Stew-000-1-0-011/voyager/docs/harness.md

# 基板外の配線

このファイルは `mechanical/harness.py` が生成する。手で編集しない。図は `mechanical/images/harness.png`。

- ケーブルはアルミフレームの上面か外面に沿わせ、結束バンドで 50〜80mm おきに留める。電装トレイの上では基板とモジュールの間をゆるく回す。
- 長さは図の経路に両端の余裕 60mm を足して 50mm 単位に切り上げた目安。実物に当てて切る。
- 電源の流れ:電池 → XT60 → ヒューズ 10A → メインスイッチ → 非常停止 → 電源分岐(レバー式コネクタ) → DRV8871 ×3 の電源端子と基板の J_PWR。電池の − は電源分岐の − へ直接つなぐ。
- モーターの 6P ケーブルは中間クロス材の前で、M1/M2(ドライバへ)とエンコーダ4本(基板へ)に分ける。
- モジュールの置き場所(トレイ上、基板の前): DRV_L / DRV_G / DRV_R を左から順に、降圧モジュールを右端。メインスイッチと電源分岐はトレイの左奥。

| 記号 | 区間 | 線材 | 端末 | 長さの目安 | 備考 |
|---|---|---|---|---|---|
| P1 | 電池 → メインスイッチ(+)/ 電源分岐(−) | AWG16 赤黒 | XT60 オス ↔ 圧着端子 | 250mm | 平形ヒューズ 10A を + 側の途中に入れる。− は分岐まで同じ経路で並走させる |
| P2 | メインスイッチ → 非常停止 | AWG16 | 圧着端子 | 150mm |  |
| P3 | 非常停止 → 電源分岐(+) | AWG16 | 圧着端子 ↔ レバー式コネクタ | 150mm |  |
| P4 | 電源分岐 → DRV_L の電源端子(VM, GND) | AWG18 赤黒 | レバー式コネクタ ↔ ネジ端子 | 200mm | 基板の左脇から前へ回し、ドライバの前を通す |
| P5 | 電源分岐 → DRV_G の電源端子(VM, GND) | AWG18 赤黒 | レバー式コネクタ ↔ ネジ端子 | 200mm | 基板の左脇から前へ回し、ドライバの前を通す |
| P6 | 電源分岐 → DRV_R の電源端子(VM, GND) | AWG18 赤黒 | レバー式コネクタ ↔ ネジ端子 | 250mm | 基板の左脇から前へ回し、ドライバの前を通す |
| P7 | 電源分岐 → 基板 J_PWR | AWG20 赤黒 | レバー式コネクタ ↔ ネジ端子 | 150mm |  |
| P8 | 基板 J_BUCK ↔ 降圧モジュール | AWG22 3本 | XH 3P ↔ はんだ付け | 300mm | 基板の左脇から前へ回す。基板を詰め直すときに J_BUCK を右前へ寄せれば短くなる |
| D1 | 基板 J_DRV_L → DRV_L の信号ピン | AWG26 4芯 | XH 4P ↔ ピンヘッダ用ソケット 4P(両端同じ順:GND, VM, IN1, IN2) | 150mm | VM の線は基板側で何もつながないので、抜いておいてもよい |
| D2 | 基板 J_DRV_G → DRV_G の信号ピン | AWG26 4芯 | XH 4P ↔ ピンヘッダ用ソケット 4P(両端同じ順:GND, VM, IN1, IN2) | 150mm | VM の線は基板側で何もつながないので、抜いておいてもよい |
| D3 | 基板 J_DRV_R → DRV_R の信号ピン | AWG26 4芯 | XH 4P ↔ ピンヘッダ用ソケット 4P(両端同じ順:GND, VM, IN1, IN2) | 100mm | VM の線は基板側で何もつながないので、抜いておいてもよい |
| M1 | 左駆動モーター → DRV_L 出力 | モーター付属 6P の M1, M2 | PH 6P ↔ ネジ端子 | 150mm | 6P ケーブルを中間クロス材の前で M1/M2 とエンコーダ4本に分ける |
| E1 | 左エンコーダ → 基板 J_ENC_L | モーター付属 6P の GND, VCC, A, B | PH 6P ↔ XH 4P | 200mm |  |
| M2 | 右駆動モーター → DRV_R 出力 | モーター付属 6P の M1, M2 | PH 6P ↔ ネジ端子 | 150mm | 6P ケーブルを中間クロス材の前で M1/M2 とエンコーダ4本に分ける |
| E2 | 右エンコーダ → 基板 J_ENC_R | モーター付属 6P の GND, VCC, A, B | PH 6P ↔ XH 4P | 200mm |  |
| M3 | 把持モーター → DRV_G 出力 | モーター付属 6P の M1, M2(延長) | PH 6P ↔ ネジ端子 | 250mm | モーター下端から中心線に沿って後ろへ。把持の上下動はないので固定でよい |
| E3 | 把持エンコーダ → 基板 J_ENC_G | モーター付属 6P の GND, VCC, A, B(延長) | PH 6P ↔ XH 4P | 300mm |  |
| S1 | 超音波 LF → 基板 J_US_LF | AWG26 4芯 | XH 4P ↔ ピンヘッダ用ソケット 4P(両端同じ順:Vcc, Trig, Echo, Gnd) | 400mm |  |
| S2 | 超音波 RF → 基板 J_US_RF | AWG26 4芯 | XH 4P ↔ ピンヘッダ用ソケット 4P(両端同じ順:Vcc, Trig, Echo, Gnd) | 350mm |  |
| S3 | 超音波 LR → 基板 J_US_LR | AWG26 4芯 | XH 4P ↔ ピンヘッダ用ソケット 4P(両端同じ順:Vcc, Trig, Echo, Gnd) | 300mm | 非常停止の前を回る |
| S4 | 超音波 RR → 基板 J_US_RR | AWG26 4芯 | XH 4P ↔ ピンヘッダ用ソケット 4P(両端同じ順:Vcc, Trig, Echo, Gnd) | 200mm | 電池箱の後ろ、後ろフレームの外面を通る |
| U1 | Bluepill USB → PC | USB ケーブル 3〜5m | Micro-B ↔ A | 3〜5m | 後ろへ出し、後ろフレームに結束して引っ張りを逃がす。USB アイソレータは PC 側に置く |
