Stew-000-1-0-011/voyager/electrical/perfboard.md

# ユニバーサル基板 配置・結線

このファイルは `gen_perfboard.py` が `netlist.py` から生成する。手で編集しない。

## Bluepill の向きの確認

- ソケット J_BP_A のピン1((19,4))に挿さる端子が **3V3**、J_BP_B のピン1((13,4))が **VB** であること。USB コネクタは基板の後端(行の大きい側)を向く。
- 実物のシルク印刷で確認する。違う場合は、ハンダ付けの前に `netlist.py` の `BLUEPILL_ROW_A` / `BLUEPILL_ROW_B` と `PLACEMENT` を直して再生成する。

## コネクタのピン順(ケーブル製作用)

ピン順は相手のモジュールの端子と同じなので、ケーブルはまっすぐ(1番どうし)つなぐ。GND のピンは基板の外周(GND の母線)側にある。図の□はピン1。空欄は基板側で何もつながないピン(ドライバの VM はバッテリーから直接)。

| コネクタ | 1 | 2 | 3 | 4 |
|---|---|---|---|---|
| J_BUCK(Buck module) | GND | VBAT | +5V |  |
| J_DRV_G(Driver IN) | GND | 未接続 | G_IN1 | G_IN2 |
| J_DRV_L(Driver IN) | GND | 未接続 | L_IN1 | L_IN2 |
| J_DRV_R(Driver IN) | GND | 未接続 | R_IN1 | R_IN2 |
| J_ENC_G(Encoder) | GND | +3V3 | ENC_G_A | ENC_G_B |
| J_ENC_L(Encoder) | GND | +3V3 | ENC_L_A | ENC_L_B |
| J_ENC_R(Encoder) | GND | +3V3 | ENC_R_A | ENC_R_B |
| J_PWR(VBAT in) | GND | VBAT |  |  |
| J_UART(UART) | GND | +3V3 | UART_TX | UART_RX |
| J_US_LF(HC-SR04) | +5V | US_TRIG_LF | US_ECHO_LF_RAW | GND |
| J_US_LR(HC-SR04) | +5V | US_TRIG_LR | US_ECHO_LR_RAW | GND |
| J_US_RF(HC-SR04) | +5V | US_TRIG_RF | US_ECHO_RF_RAW | GND |
| J_US_RR(HC-SR04) | +5V | US_TRIG_RR | US_ECHO_RR_RAW | GND |

## 部品配置

基板は 33 × 28 穴(2.54mm 格子、約 84 × 71mm)。部品面から見て、列 0 がロボットの左端、行 0 が前端。回転はピン番号が進む向き(0: 列+、90: 行+、180: 列−、270: 行−)。

| ref | 値 | ピン1の穴 | 回転 |
|---|---|---|---|
| C_BULK | 470u 25V | (4,25) | 90 |
| C_DIV | 100n | (10,22) | 0 |
| D_5V | 1N5819 | (13,26) | 0 |
| J_BP_A | Bluepill row A | (19,4) | 90 |
| J_BP_B | Bluepill row B | (13,4) | 90 |
| J_BUCK | Buck module | (7,27) | 270 |
| J_DRV_G | Driver IN | (21,0) | 90 |
| J_DRV_L | Driver IN | (11,0) | 90 |
| J_DRV_R | Driver IN | (24,0) | 90 |
| J_ENC_G | Encoder | (32,4) | 180 |
| J_ENC_L | Encoder | (0,7) | 0 |
| J_ENC_R | Encoder | (32,9) | 180 |
| J_PWR | VBAT in | (1,27) | 270 |
| J_UART | UART | (5,0) | 90 |
| J_US_LF | HC-SR04 | (3,16) | 180 |
| J_US_LR | HC-SR04 | (3,20) | 180 |
| J_US_RF | HC-SR04 | (29,20) | 0 |
| J_US_RR | HC-SR04 | (29,25) | 0 |
| R_DIV_H | 47k | (10,25) | 0 |
| R_DIV_L | 10k | (15,25) | 270 |
| R_ECHO_LF | 1k | (2,18) | 0 |
| R_ECHO_LR | 1k | (4,23) | 0 |
| R_ECHO_RF | 1k | (29,17) | 270 |
| R_ECHO_RR | 1k | (27,25) | 270 |
| R_USB | 1k8 DNP | (17,19) | 270 |

## 配線経路

配線はすべてはんだ面で行う。電源(VBAT、GND)も基板上の電流は小さい(降圧モジュールの入力と電圧測定だけ)ので、信号と同じ線で引く。作業順:(1)はんだ面の裸配線(すずめっき線を穴に沿って這わせ、通る穴ごとにはんだ付け)、(2)はんだ面の被覆線(耐熱の被覆線、たとえば AWG26〜30 の ETFE ラッピング線を、裸配線の上から穴の列に沿って這わせる。はんだ付けは両端だけで、端はピンのはんだの上か、裸配線の上に付ける。裸配線や他の被覆線とは直角に交差してよいが、途中で他のピンのはんだの上は通さない)。ポリウレタン線ははんだごての熱で被覆が溶けるので、交差に使わない。図は `images/perfboard_top.png`(部品面)、`images/perfboard_bottom.png`(はんだ面の裸配線)、`images/perfboard_wires.png`(はんだ面の被覆線)。はんだ面の図は左右反転。

裸配線 37 本、被覆線 14 本。

### (1) はんだ面の裸配線

| ✓ | ネット | 経路(角の穴) |
|---|---|---|
| ☐ | +3V3 | (5,1) → (1,1) → (1,7) |
| ☐ | +3V3 | (13,21) → (14,21) → (14,18) → (17,18) → (17,15) |
| ☐ | +3V3 | (25,4) → (25,3) → (31,3) → (31,4) |
| ☐ | +3V3 | (31,4) → (31,9) |
| ☐ | +5V | (3,20) → (7,20) → (7,25) |
| ☐ | +5V | (17,26) → (28,26) → (28,25) → (29,25) |
| ☐ | ENC_G_A | (19,12) → (25,12) → (25,7) → (30,7) → (30,4) |
| ☐ | ENC_G_B | (19,13) → (26,13) → (26,8) → (29,8) |
| ☐ | ENC_L_B | (3,7) → (3,13) → (12,13) → (12,15) → (13,15) |
| ☐ | ENC_R_A | (19,19) → (22,19) → (22,17) → (28,17) → (28,16) → (30,16) → (30,9) |
| ☐ | ENC_R_B | (19,18) → (21,18) → (21,14) → (27,14) → (27,9) → (29,9) |
| ☐ | GND | (0,0) → (32,0) → (32,27) → (0,27) → (0,1) |
| ☐ | GND | (4,27) → (4,26) |
| ☐ | GND | (12,22) → (13,22) → (13,23) |
| ☐ | GND | (13,22) → (15,22) → (15,21) |
| ☐ | G_IN1 | (19,7) → (20,7) → (20,2) → (21,2) |
| ☐ | G_IN2 | (19,8) → (21,8) → (21,3) |
| ☐ | L_IN1 | (11,2) → (12,2) → (12,8) → (13,8) |
| ☐ | L_IN2 | (11,3) → (11,9) → (13,9) |
| ☐ | R_IN1 | (19,9) → (22,9) → (22,2) → (24,2) |
| ☐ | R_IN2 | (19,10) → (24,10) → (24,3) |
| ☐ | UART_RX | (5,3) → (7,3) → (7,11) → (13,11) |
| ☐ | UART_TX | (5,2) → (10,2) → (10,10) → (13,10) |
| ☐ | USB_DP | (17,19) → (18,19) → (18,15) → (19,15) |
| ☐ | US_ECHO_LF | (6,18) → (13,18) |
| ☐ | US_ECHO_LF_RAW | (1,16) → (1,18) → (2,18) |
| ☐ | US_ECHO_LR | (8,23) → (8,20) → (12,20) → (12,19) → (13,19) |
| ☐ | US_ECHO_LR_RAW | (1,20) → (1,23) → (4,23) |
| ☐ | US_ECHO_RF_RAW | (29,17) → (29,19) → (31,19) → (31,20) |
| ☐ | US_TRIG_LF | (2,16) → (2,15) → (10,15) → (10,16) → (13,16) |
| ☐ | US_TRIG_LR | (2,20) → (2,19) → (5,19) → (5,17) → (13,17) |
| ☐ | US_TRIG_RR | (19,22) → (25,22) → (25,24) → (30,24) → (30,25) |
| ☐ | VBAT | (1,25) → (4,25) |
| ☐ | VBAT | (4,25) → (6,25) → (6,26) → (7,26) |
| ☐ | VBAT | (7,26) → (10,26) → (10,25) |
| ☐ | VBAT_SENSE | (10,22) → (11,22) → (11,25) → (14,25) |
| ☐ | VBAT_SENSE | (14,25) → (15,25) |

### (2) はんだ面の被覆線

| ✓ | ネット | 経路(角の穴、はんだ付けは両端だけ) |
|---|---|---|
| ☐ | +3V3 | (19,4) → (19,3) → (12,3) → (12,4) → (6,4) → (6,1) → (5,1) |
| ☐ | +3V3 | (19,4) → (25,4) |
| ☐ | +5V | (3,16) → (3,20) |
| ☐ | +5V | (7,25) → (7,24) → (17,24) → (17,26) |
| ☐ | +5V | (29,25) → (29,20) |
| ☐ | +5V_BP | (13,26) → (16,26) → (16,6) → (19,6) |
| ☐ | ENC_G_B | (29,8) → (29,4) |
| ☐ | ENC_L_A | (2,7) → (2,14) → (13,14) |
| ☐ | GND | (12,27) → (12,22) |
| ☐ | US_ECHO_RF | (19,21) → (20,21) → (20,13) → (29,13) |
| ☐ | US_ECHO_RR | (19,23) → (27,23) → (27,21) |
| ☐ | US_ECHO_RR_RAW | (27,25) → (27,26) → (31,26) → (31,25) |
| ☐ | US_TRIG_RF | (19,20) → (27,20) → (27,19) → (30,19) → (30,20) |
| ☐ | VBAT_SENSE | (10,22) → (10,12) → (13,12) |

## 結線表

ネットごとに、近い順につなぐ。

| ✓ | ネット | 始点 | 終点 |
|---|---|---|---|
| ☐ | +3V3 | J_ENC_L.2 @ (1,7) | J_UART.2 @ (5,1) |
| ☐ | +3V3 | J_UART.2 @ (5,1) | J_BP_A.1 @ (19,4) |
| ☐ | +3V3 | J_BP_A.1 @ (19,4) | J_ENC_G.2 @ (31,4) |
| ☐ | +3V3 | J_ENC_G.2 @ (31,4) | J_ENC_R.2 @ (31,9) |
| ☐ | +3V3 | J_ENC_R.2 @ (31,9) | R_USB.2 @ (17,15) |
| ☐ | +3V3 | R_USB.2 @ (17,15) | J_BP_B.18 @ (13,21) |
| ☐ | +5V | J_US_LF.1 @ (3,16) | J_US_LR.1 @ (3,20) |
| ☐ | +5V | J_US_LR.1 @ (3,20) | J_BUCK.3 @ (7,25) |
| ☐ | +5V | J_BUCK.3 @ (7,25) | D_5V.2 @ (17,26) |
| ☐ | +5V | D_5V.2 @ (17,26) | J_US_RR.1 @ (29,25) |
| ☐ | +5V | J_US_RR.1 @ (29,25) | J_US_RF.1 @ (29,20) |
| ☐ | +5V_BP | D_5V.1 @ (13,26) | J_BP_A.3 @ (19,6) |
| ☐ | ENC_G_A | J_BP_A.9 @ (19,12) | J_ENC_G.3 @ (30,4) |
| ☐ | ENC_G_B | J_BP_A.10 @ (19,13) | J_ENC_G.4 @ (29,4) |
| ☐ | ENC_L_A | J_ENC_L.3 @ (2,7) | J_BP_B.11 @ (13,14) |
| ☐ | ENC_L_B | J_ENC_L.4 @ (3,7) | J_BP_B.12 @ (13,15) |
| ☐ | ENC_R_A | J_BP_A.16 @ (19,19) | J_ENC_R.3 @ (30,9) |
| ☐ | ENC_R_B | J_BP_A.15 @ (19,18) | J_ENC_R.4 @ (29,9) |
| ☐ | GND | J_ENC_L.1 @ (0,7) | J_US_LF.4 @ (0,16) |
| ☐ | GND | J_US_LF.4 @ (0,16) | J_US_LR.4 @ (0,20) |
| ☐ | GND | J_US_LR.4 @ (0,20) | J_PWR.1 @ (1,27) |
| ☐ | GND | J_PWR.1 @ (1,27) | C_BULK.2 @ (4,26) |
| ☐ | GND | C_BULK.2 @ (4,26) | J_BUCK.1 @ (7,27) |
| ☐ | GND | J_BUCK.1 @ (7,27) | C_DIV.2 @ (12,22) |
| ☐ | GND | C_DIV.2 @ (12,22) | J_BP_B.19 @ (13,22) |
| ☐ | GND | J_BP_B.19 @ (13,22) | J_BP_B.20 @ (13,23) |
| ☐ | GND | J_BP_B.20 @ (13,23) | R_DIV_L.2 @ (15,21) |
| ☐ | GND | R_DIV_L.2 @ (15,21) | J_US_RF.4 @ (32,20) |
| ☐ | GND | J_US_RF.4 @ (32,20) | J_US_RR.4 @ (32,25) |
| ☐ | GND | J_US_RR.4 @ (32,25) | J_ENC_R.1 @ (32,9) |
| ☐ | GND | J_ENC_R.1 @ (32,9) | J_ENC_G.1 @ (32,4) |
| ☐ | GND | J_ENC_G.1 @ (32,4) | J_DRV_R.1 @ (24,0) |
| ☐ | GND | J_DRV_R.1 @ (24,0) | J_DRV_G.1 @ (21,0) |
| ☐ | GND | J_DRV_G.1 @ (21,0) | J_BP_A.2 @ (19,5) |
| ☐ | GND | J_BP_A.2 @ (19,5) | J_DRV_L.1 @ (11,0) |
| ☐ | GND | J_DRV_L.1 @ (11,0) | J_UART.1 @ (5,0) |
| ☐ | G_IN1 | J_BP_A.4 @ (19,7) | J_DRV_G.3 @ (21,2) |
| ☐ | G_IN2 | J_BP_A.5 @ (19,8) | J_DRV_G.4 @ (21,3) |
| ☐ | L_IN1 | J_DRV_L.3 @ (11,2) | J_BP_B.5 @ (13,8) |
| ☐ | L_IN2 | J_DRV_L.4 @ (11,3) | J_BP_B.6 @ (13,9) |
| ☐ | R_IN1 | J_BP_A.6 @ (19,9) | J_DRV_R.3 @ (24,2) |
| ☐ | R_IN2 | J_BP_A.7 @ (19,10) | J_DRV_R.4 @ (24,3) |
| ☐ | UART_RX | J_UART.4 @ (5,3) | J_BP_B.8 @ (13,11) |
| ☐ | UART_TX | J_UART.3 @ (5,2) | J_BP_B.7 @ (13,10) |
| ☐ | USB_DP | R_USB.1 @ (17,19) | J_BP_A.12 @ (19,15) |
| ☐ | US_ECHO_LF | R_ECHO_LF.2 @ (6,18) | J_BP_B.15 @ (13,18) |
| ☐ | US_ECHO_LF_RAW | J_US_LF.3 @ (1,16) | R_ECHO_LF.1 @ (2,18) |
| ☐ | US_ECHO_LR | R_ECHO_LR.2 @ (8,23) | J_BP_B.16 @ (13,19) |
| ☐ | US_ECHO_LR_RAW | J_US_LR.3 @ (1,20) | R_ECHO_LR.1 @ (4,23) |
| ☐ | US_ECHO_RF | J_BP_A.18 @ (19,21) | R_ECHO_RF.2 @ (29,13) |
| ☐ | US_ECHO_RF_RAW | R_ECHO_RF.1 @ (29,17) | J_US_RF.3 @ (31,20) |
| ☐ | US_ECHO_RR | J_BP_A.20 @ (19,23) | R_ECHO_RR.2 @ (27,21) |
| ☐ | US_ECHO_RR_RAW | R_ECHO_RR.1 @ (27,25) | J_US_RR.3 @ (31,25) |
| ☐ | US_TRIG_LF | J_US_LF.2 @ (2,16) | J_BP_B.13 @ (13,16) |
| ☐ | US_TRIG_LR | J_US_LR.2 @ (2,20) | J_BP_B.14 @ (13,17) |
| ☐ | US_TRIG_RF | J_BP_A.17 @ (19,20) | J_US_RF.2 @ (30,20) |
| ☐ | US_TRIG_RR | J_BP_A.19 @ (19,22) | J_US_RR.2 @ (30,25) |
| ☐ | VBAT | J_PWR.2 @ (1,25) | C_BULK.1 @ (4,25) |
| ☐ | VBAT | C_BULK.1 @ (4,25) | J_BUCK.2 @ (7,26) |
| ☐ | VBAT | J_BUCK.2 @ (7,26) | R_DIV_H.1 @ (10,25) |
| ☐ | VBAT_SENSE | C_DIV.1 @ (10,22) | R_DIV_H.2 @ (14,25) |
| ☐ | VBAT_SENSE | R_DIV_H.2 @ (14,25) | R_DIV_L.1 @ (15,25) |
| ☐ | VBAT_SENSE | R_DIV_L.1 @ (15,25) | J_BP_B.9 @ (13,12) |

## 導通確認

- 結線表の各行を、テスターの導通モードで確認して ✓ を付ける。
- 次の組み合わせが **短絡していない** ことを確認する(電源を入れる前に必ず行う)。
  - ☐ VBAT と GND
  - ☐ +5V と GND
  - ☐ +5V_BP と GND
  - ☐ +3V3 と GND
  - ☐ VBAT と +5V
