Stew-000-1-0-011/voyager/docs/rules.md

# ルールの要点(このロボットに関係するもの)

出典:千葉大学ロボットコンテスト 2026 競技課題および規則。条文番号は規則のもの。

- **ノーツ:** 一辺約150mm の立方体の段ボール箱、200g(Q2)。おもりは6面の裏の中心に均等に固定(Q11、Q14)。各チーム6個が、ノーツゾーンの壁際に約48.5mm 間隔で床に並ぶ(2.1.4、Q12)。
- **保持の定義(2.4.2):** 挟む、吸い付く、積載するなどの方法でロボットに運ばせること。このロボットは「横から挟んで床を引きずる」。該当するか運営に確認する。
- **保持の上限(2.4.3):** スラロームゾーン内では最大2個。拾った瞬間に再判定される(2.4.5)。
- **得点:** 最初のノーツ保持で10点、最初のスラローム通過で5点(2.9.1、2.9.2)。
- **場外:** ノーツがフィールド外に出ると30点減点、そのノーツは戻せない(2.4.6)。
- **木枠(3.3、Q3、Q21):** 上面には触れてよい。側面に触れてはいけない(軽い接触は容認、押して進む挙動は強制リスタート)。壁に押し付けて向きを直すのは禁止。
- **ゴールゾーンの黒い領域(Q13):** ノーツを保持した状態でしか入れない。ノーツを置いたら速やかに出る。
- **妨害(2.6):** 妨害機は各チーム1機まで。このロボットは妨害も妨害権のチャージも行わない。
- **リトライ(2.12):** 宣言でき、全ロボットをスタートゾーンに戻す。保持しているノーツはノーツエリアに戻す。
- **サイズ(6.2):** 本体 W600 × D600 × H800 以内、競技中は 900 × 900 × 900 以内。
- **電源(6.4.1、6.4.2):** 公称 24V 以下、任意2点間 42V 以下。二次電池の使用は事前申告。
- **無線(6.5):** 使う場合は事前許可。有線(USB)なら不要。
- **自動ロボット(6.6):** 大まかな仕様を事前に通知する。
- **安全(7.1):** 非常停止ボタン(黄色の台、赤いボタン)を押しやすい位置に付ける。
- **試合時間:** 5分(2.10.1)。セッティング1分(2.1.1)。
