Stew-000-1-0-011/voyager/electrical/images/perfboard_bottom.png

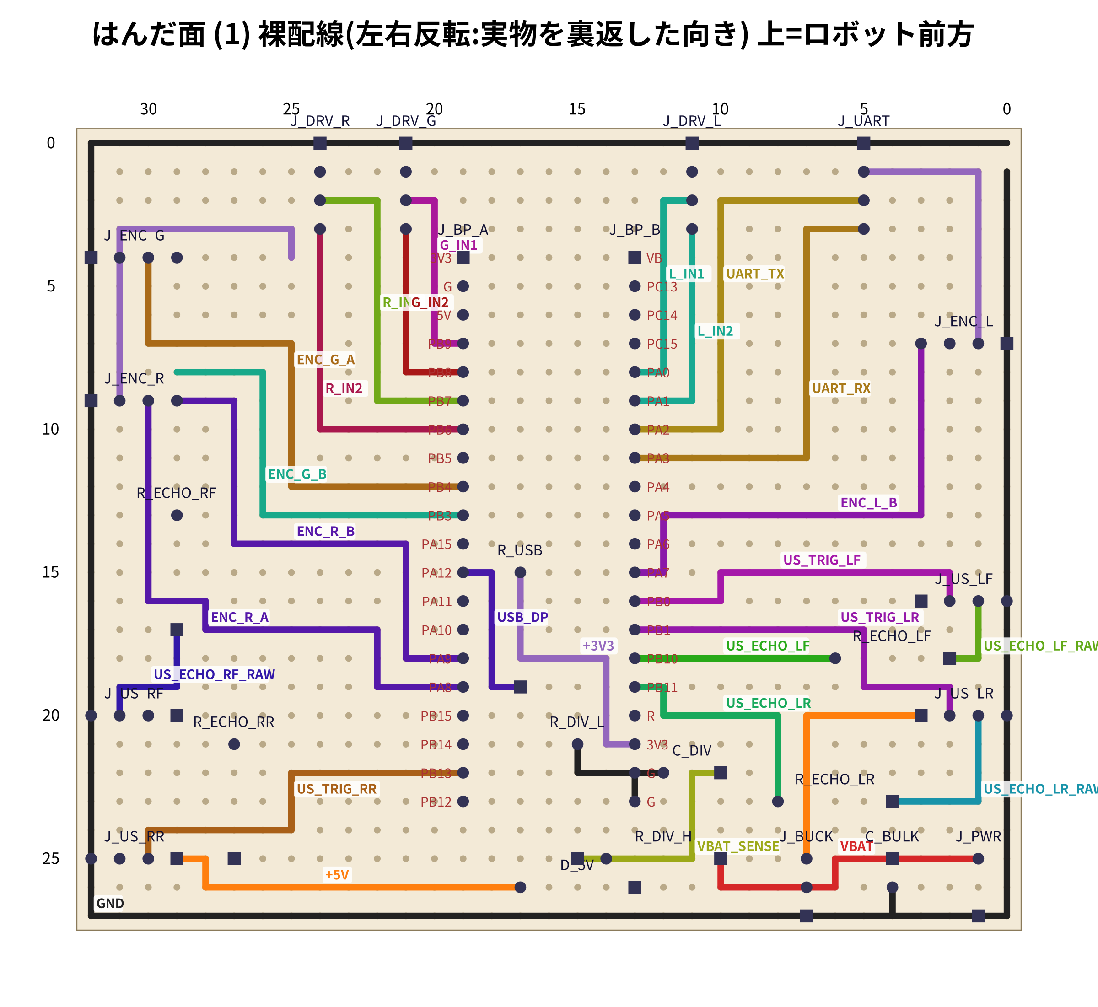
electrical/images/perfboard_bottom.png
