Stew-000-1-0-011/voyager/electrical/images/perfboard_top.png

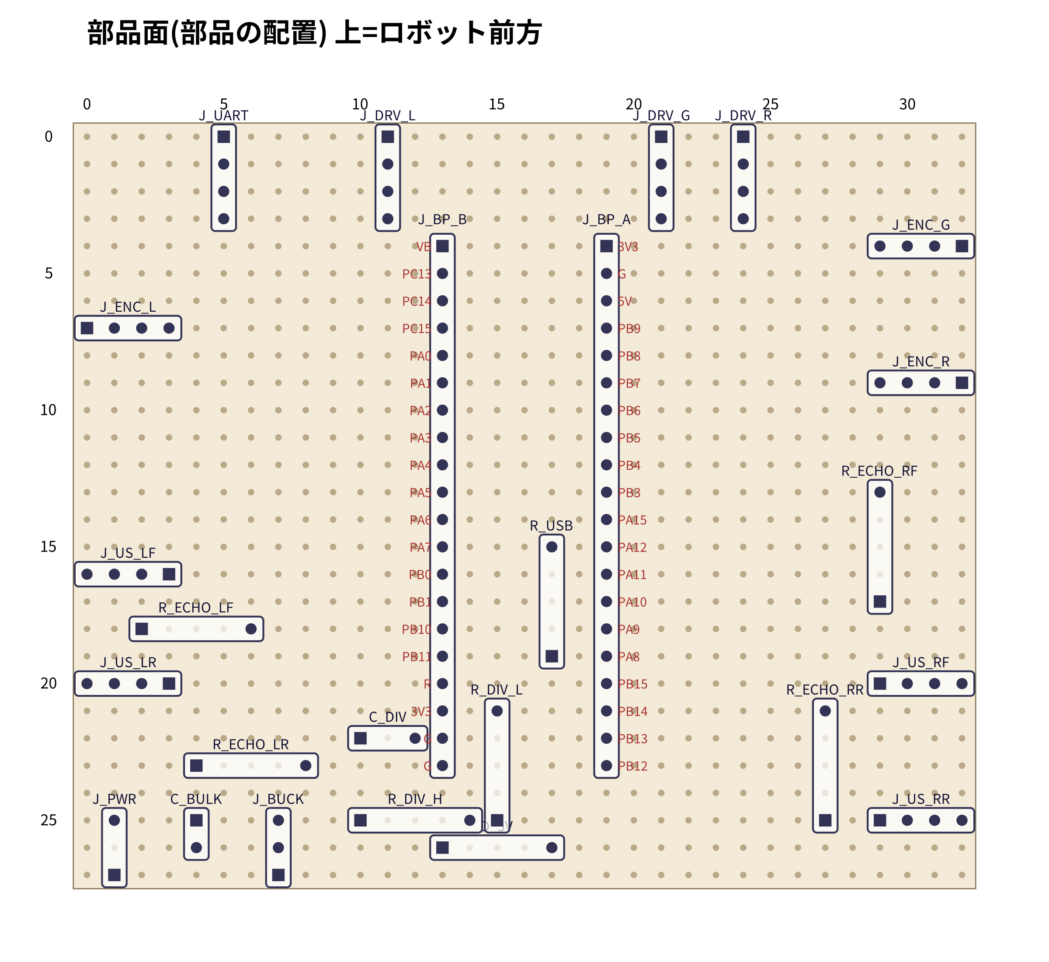
electrical/images/perfboard_top.png
