Stew-000-1-0-011/voyager/electrical/images/perfboard_wires.png

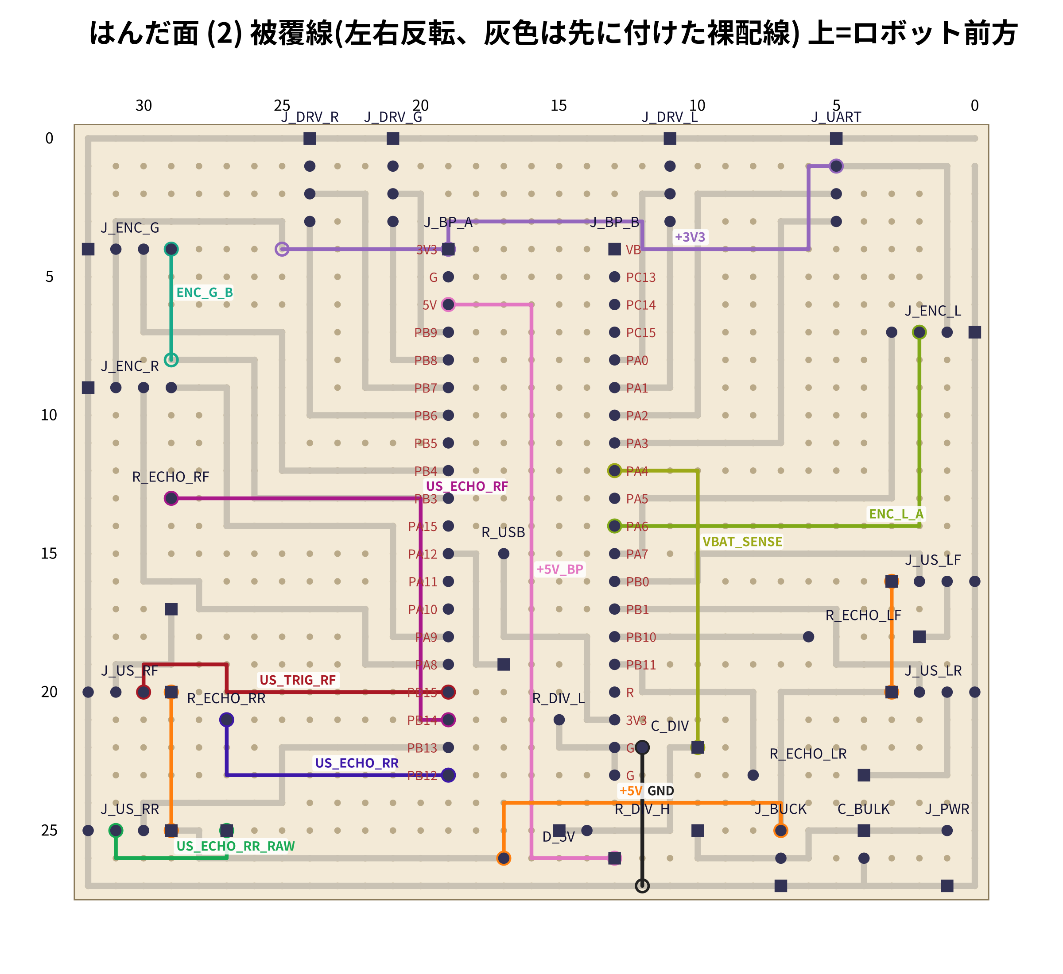
electrical/images/perfboard_wires.png
