Stew-000-1-0-011/voyager/electrical/images/schematic.png

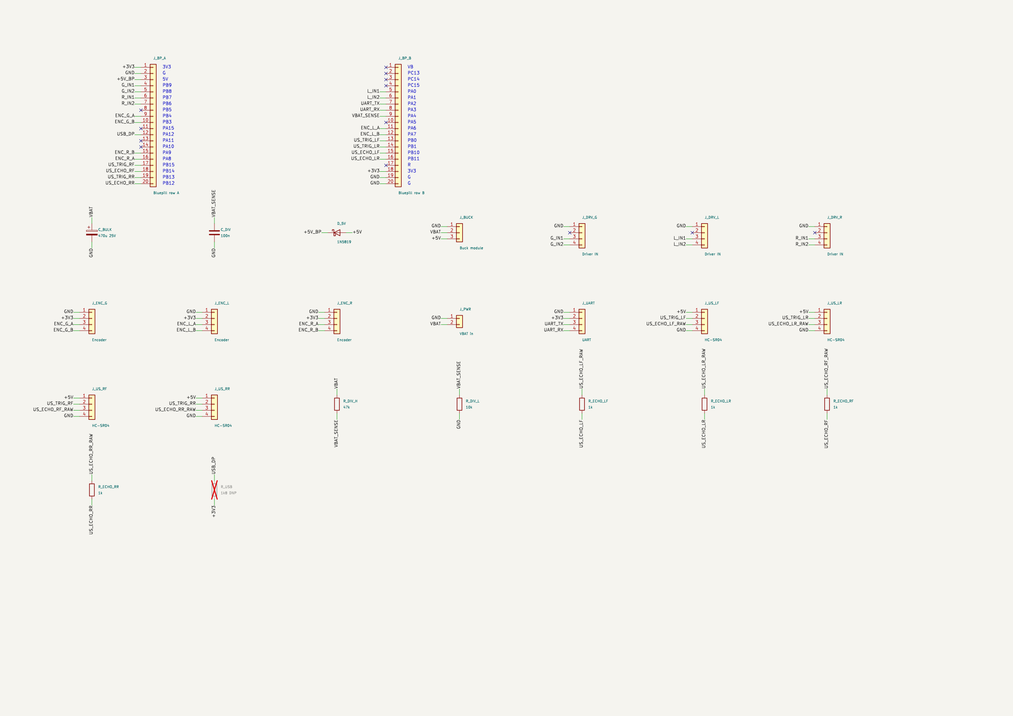
electrical/images/schematic.png
