Stew-000-1-0-011/voyager/mechanical/images/harness.png

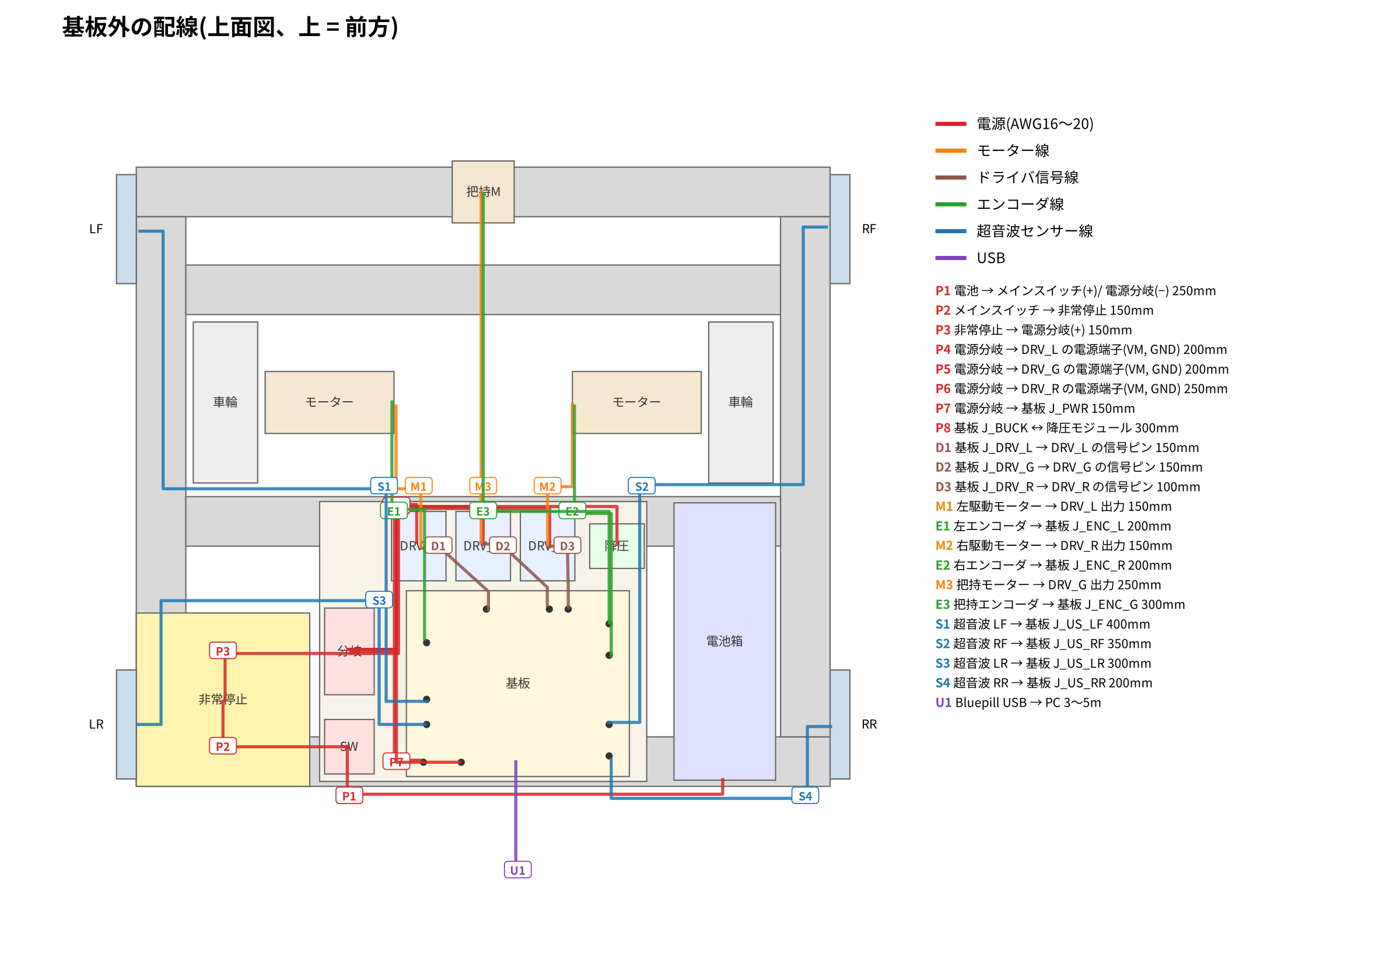
mechanical/images/harness.png
