Stew-000-1-0-011/voyager/mechanical/images/parts_printed.png

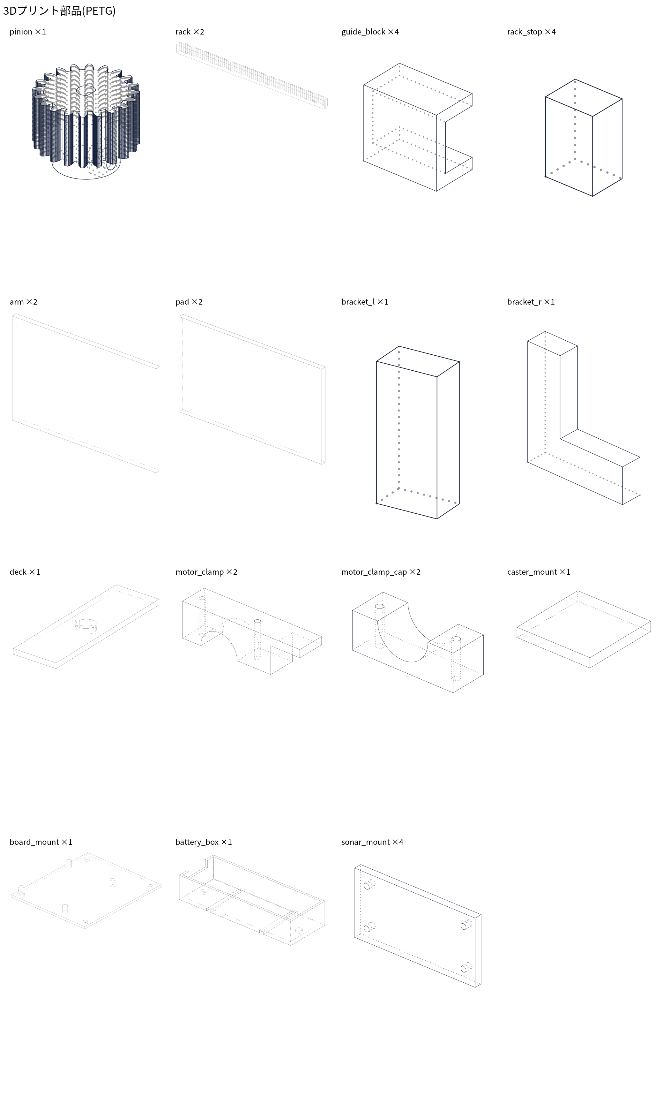
mechanical/images/parts_printed.png
