Stew-000-1-0-011/voyager/mechanical/images/assembly_closed_iso.png

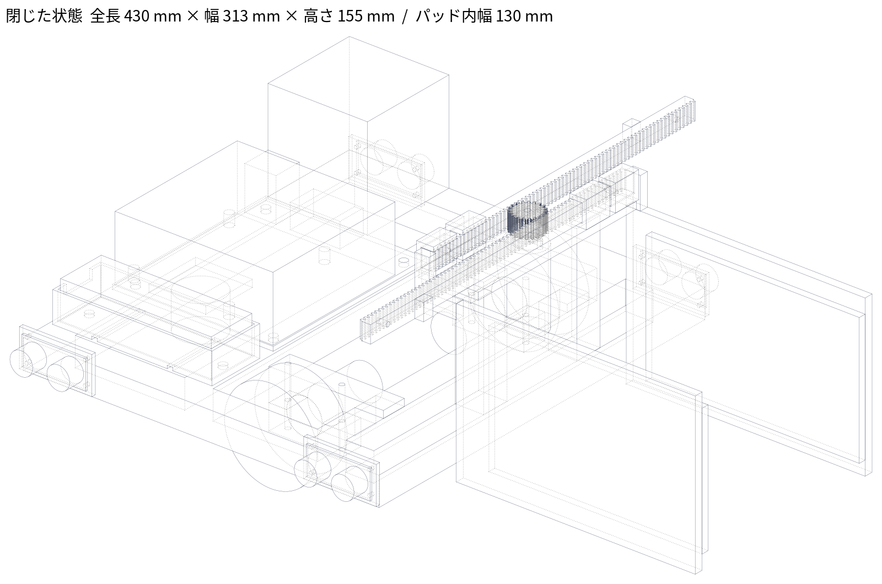
mechanical/images/assembly_closed_iso.png
