Stew-000-1-0-011/voyager/electrical/carrier.kicad_sch

## KiCad design electrical/carrier.kicad_sch (2026-10-15)

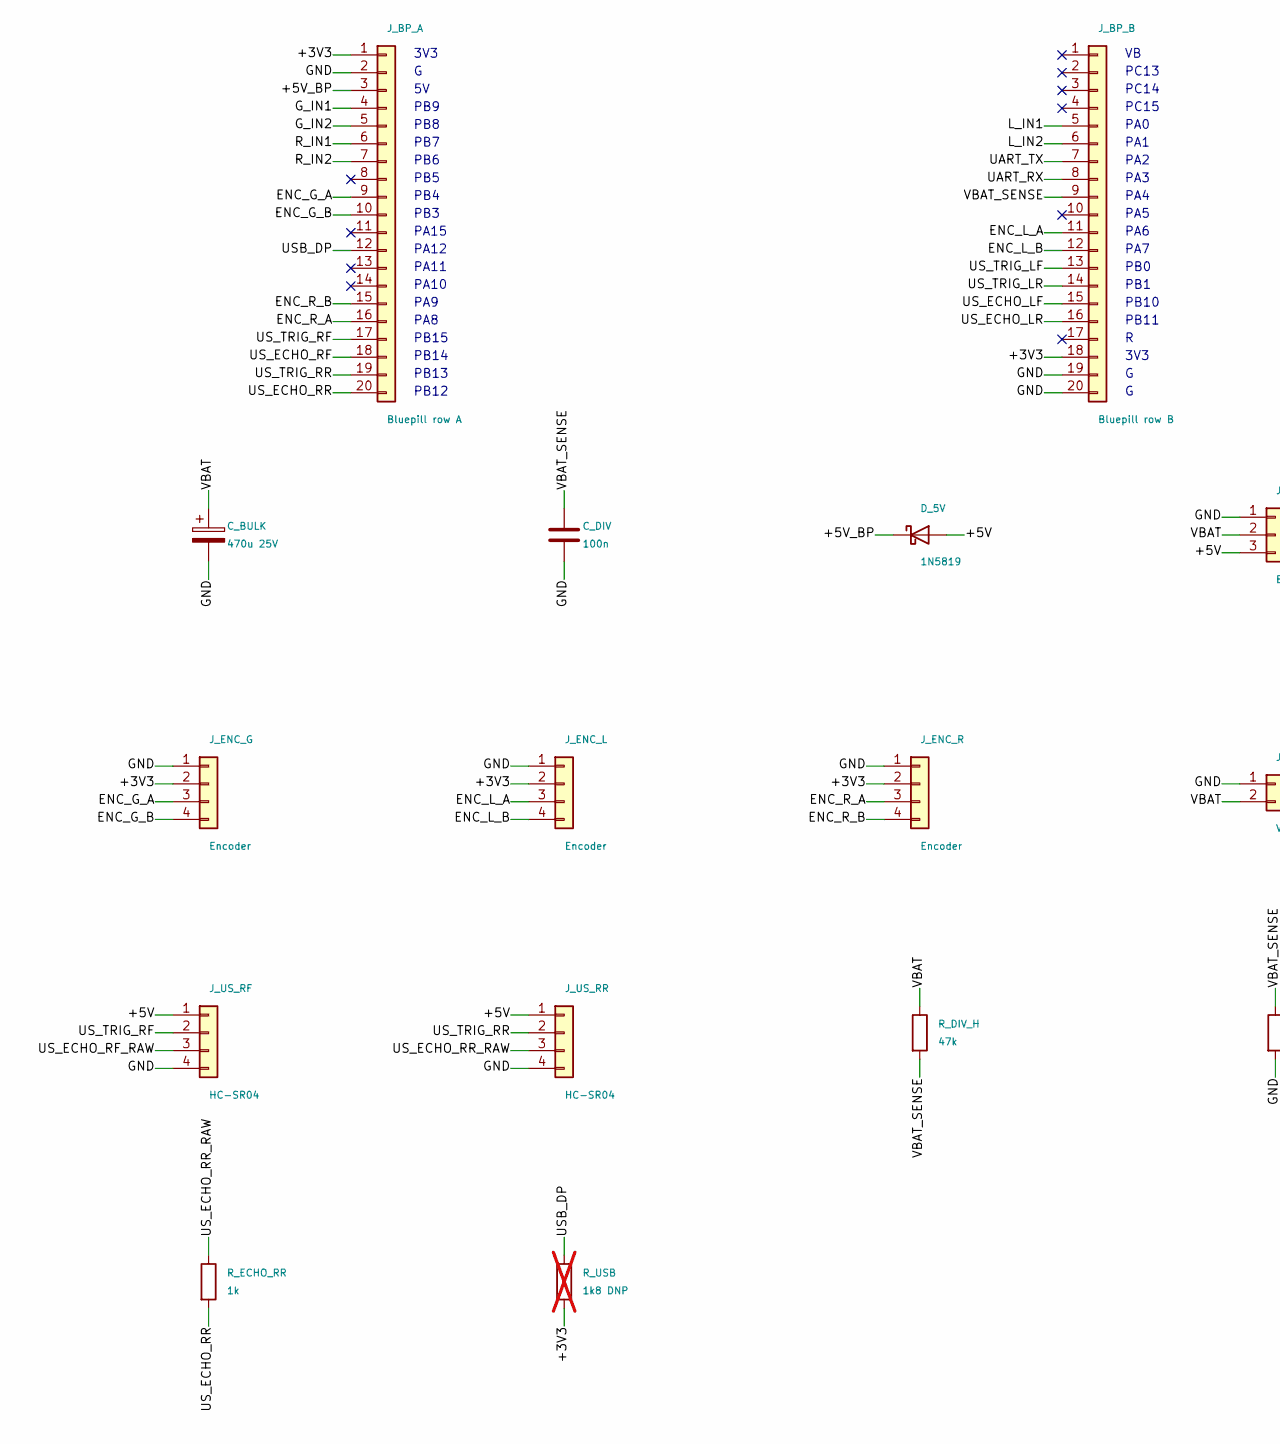
[picture p11: schematic carrier.kicad_sch, part in row 1, column 1]

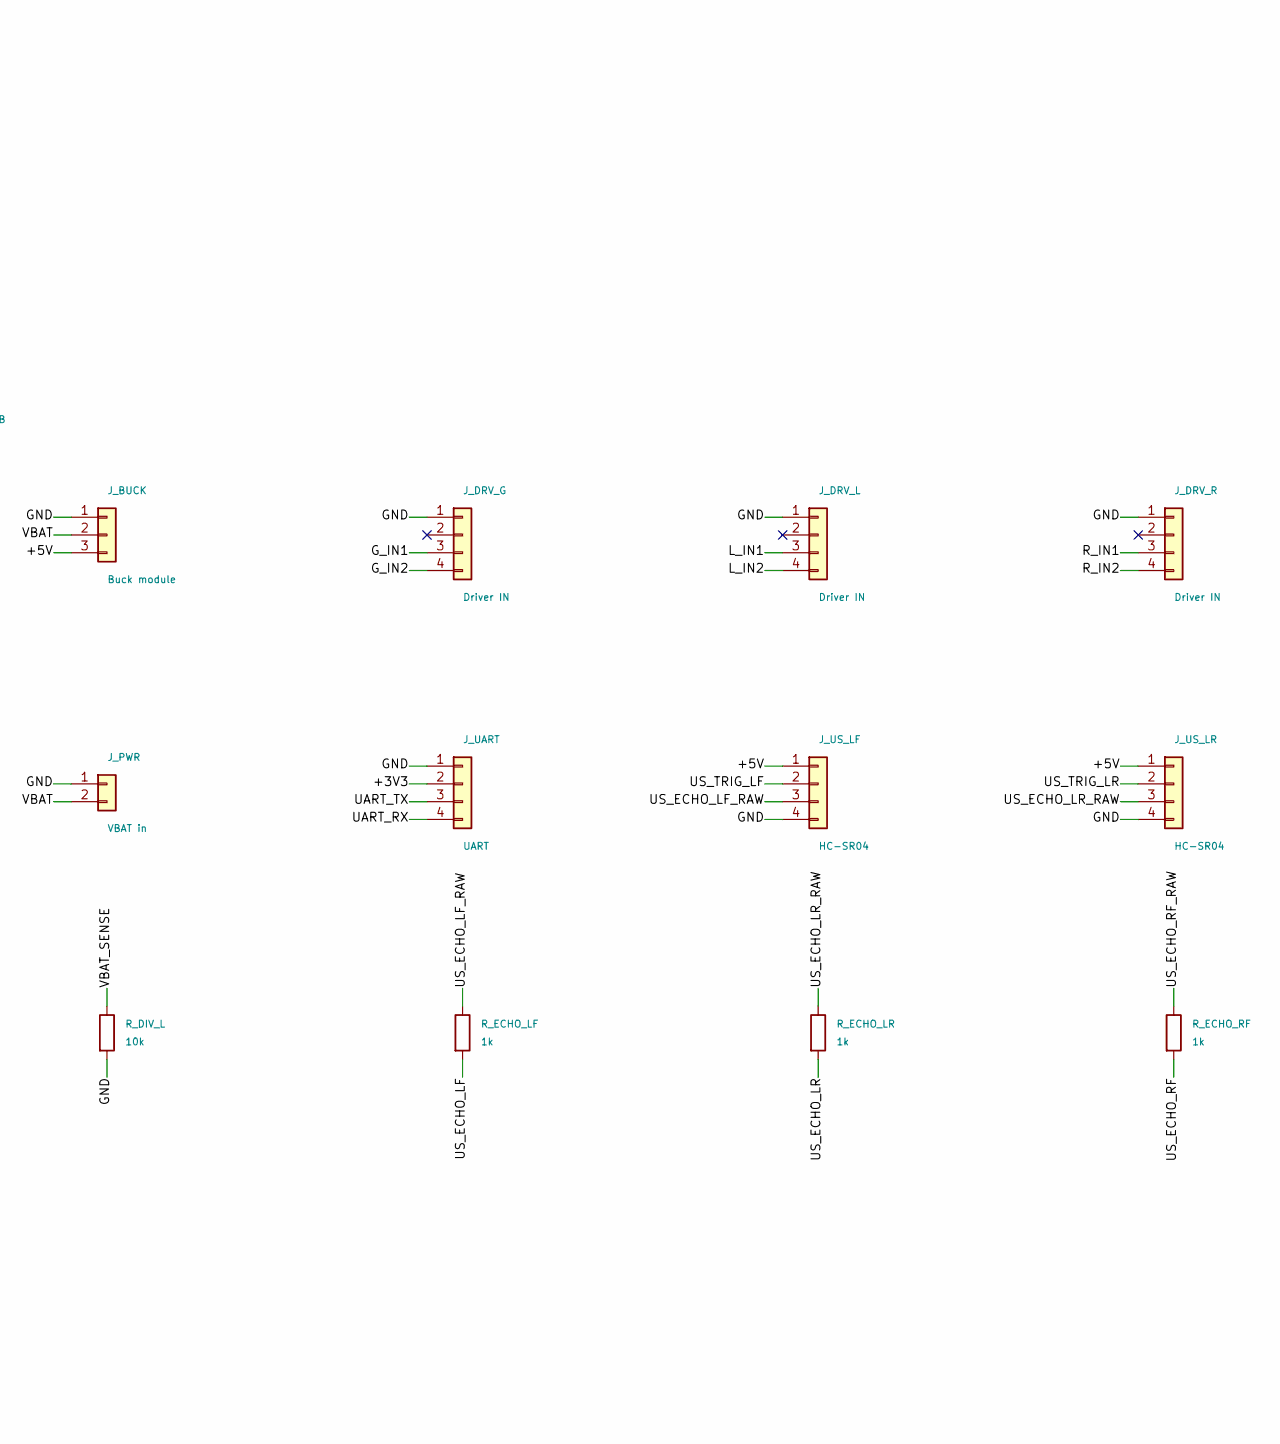
[picture p12: schematic carrier.kicad_sch, part in row 1, column 2]

Parts:
C_BULK: 470u 25V; CP_Radial_D8.0mm_P3.50mm
C_DIV: 100n; C_Disc_D5.0mm_W2.5mm_P5.00mm
D_5V: 1N5819; D_DO-41_SOD81_P10.16mm_Horizontal
J_BP_A: Bluepill row A; PinSocket_1x20_P2.54mm_Vertical
J_BP_B: Bluepill row B; PinSocket_1x20_P2.54mm_Vertical
J_BUCK: Buck module; JST_XH_B3B-XH-A_1x03_P2.50mm_Vertical
J_DRV_G: Driver IN; JST_XH_B4B-XH-A_1x04_P2.50mm_Vertical
J_DRV_L: Driver IN; JST_XH_B4B-XH-A_1x04_P2.50mm_Vertical
J_DRV_R: Driver IN; JST_XH_B4B-XH-A_1x04_P2.50mm_Vertical
J_ENC_G: Encoder; JST_XH_B4B-XH-A_1x04_P2.50mm_Vertical
J_ENC_L: Encoder; JST_XH_B4B-XH-A_1x04_P2.50mm_Vertical
J_ENC_R: Encoder; JST_XH_B4B-XH-A_1x04_P2.50mm_Vertical
J_PWR: VBAT in; TerminalBlock_Phoenix_MKDS-1,5-2-5.08_1x02_P5.08mm_Horizont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
J_UART: UART; JST_XH_B4B-XH-A_1x04_P2.50mm_Vertical
J_US_LF: HC-SR04; JST_XH_B4B-XH-A_1x04_P2.50mm_Vertical
J_US_LR: HC-SR04; JST_XH_B4B-XH-A_1x04_P2.50mm_Vertical
J_US_RF: HC-SR04; JST_XH_B4B-XH-A_1x04_P2.50mm_Vertical
J_US_RR: HC-SR04; JST_XH_B4B-XH-A_1x04_P2.50mm_Vertical
R_DIV_H: 47k; R_Axial_DIN0207_L6.3mm_D2.5mm_P10.16mm_Horizontal
R_DIV_L: 10k; R_Axial_DIN0207_L6.3mm_D2.5mm_P10.16mm_Horizontal
R_ECHO_LF: 1k; R_Axial_DIN0207_L6.3mm_D2.5mm_P10.16mm_Horizontal
R_ECHO_LR: 1k; R_Axial_DIN0207_L6.3mm_D2.5mm_P10.16mm_Horizontal
R_ECHO_RF: 1k; R_Axial_DIN0207_L6.3mm_D2.5mm_P10.16mm_Horizontal
R_ECHO_RR: 1k; R_Axial_DIN0207_L6.3mm_D2.5mm_P10.16mm_Horizontal
R_USB: 1k8 DNP; R_Axial_DIN0207_L6.3mm_D2.5mm_P10.16mm_Horizontal; not fitted

Connections:
+3V3: J_BP_A.1, J_BP_B.18, J_ENC_G.2, J_ENC_L.2, J_ENC_R.2, J_UART.2, R_USB.2
+5V: D_5V.2 (A), J_BUCK.3, J_US_LF.1, J_US_LR.1, J_US_RF.1, J_US_RR.1
+5V_BP: D_5V.1 (K), J_BP_A.3
ENC_G_A: J_BP_A.9, J_ENC_G.3
ENC_G_B: J_BP_A.10, J_ENC_G.4
ENC_L_A: J_BP_B.11, J_ENC_L.3
ENC_L_B: J_BP_B.12, J_ENC_L.4
ENC_R_A: J_BP_A.16, J_ENC_R.3
ENC_R_B: J_BP_A.15, J_ENC_R.4
GND: C_BULK.2, C_DIV.2, J_BP_A.2, J_BP_B.19, J_BP_B.20, J_BUCK.1, J_DRV_G.1, J_DRV_L.1, J_DRV_R.1, J_ENC_G.1, J_ENC_L.1, J_ENC_R.1, J_PWR.1, J_UART.1, J_US_LF.4, J_US_LR.4, J_US_RF.4, J_US_RR.4, R_DIV_L.2
G_IN1: J_BP_A.4, J_DRV_G.3
G_IN2: J_BP_A.5, J_DRV_G.4
L_IN1: J_BP_B.5, J_DRV_L.3
L_IN2: J_BP_B.6, J_DRV_L.4
R_IN1: J_BP_A.6, J_DRV_R.3
R_IN2: J_BP_A.7, J_DRV_R.4
UART_RX: J_BP_B.8, J_UART.4
UART_TX: J_BP_B.7, J_UART.3
USB_DP: J_BP_A.12, R_USB.1
US_ECHO_LF: J_BP_B.15, R_ECHO_LF.2
US_ECHO_LF_RAW: J_US_LF.3, R_ECHO_LF.1
US_ECHO_LR: J_BP_B.16, R_ECHO_LR.2
US_ECHO_LR_RAW: J_US_LR.3, R_ECHO_LR.1
US_ECHO_RF: J_BP_A.18, R_ECHO_RF.2
US_ECHO_RF_RAW: J_US_RF.3, R_ECHO_RF.1
US_ECHO_RR: J_BP_A.20, R_ECHO_RR.2
US_ECHO_RR_RAW: J_US_RR.3, R_ECHO_RR.1
US_TRIG_LF: J_BP_B.13, J_US_LF.2
US_TRIG_LR: J_BP_B.14, J_US_LR.2
US_TRIG_RF: J_BP_A.17, J_US_RF.2
US_TRIG_RR: J_BP_A.19, J_US_RR.2
VBAT: C_BULK.1, J_BUCK.2, J_PWR.2, R_DIV_H.1
VBAT_SENSE: C_DIV.1, J_BP_B.9, R_DIV_H.2, R_DIV_L.1

Notes on the sheet:
3V3
PB3
PA15
PA12
PA11
PA10
PA9
PA8
PB15
PB14
PB13
PB12
PB9
PB8
PB7
PB6
PB5
PB4
PA5
PA6
PA7
PB0
PB1
PB10
PB11
PC13
PC14
PC15
PA0
PA1
PA2
PA3
PA4
