Stew-000-1-0-011/voyager/firmware/firmware/build.rs

use std::{env, fs, path::PathBuf};

fn main() {
    let out = PathBuf::from(env::var_os("OUT_DIR").unwrap());
    fs::copy("memory.x", out.join("memory.x")).unwrap();
    println!("cargo:rustc-link-search={}", out.display());
    println!("cargo:rerun-if-changed=memory.x");
    println!("cargo:rerun-if-changed=build.rs");
}
