Stew-000-1-0-011/voyager/(commit log)

2026-10-15 docs(spec): connect driver/buck modules by cable; closed gripper width 130mm
    Claude-Session: https://claude.ai/code/session_01ENsByEFNd15FuMFFPy7PpL
2026-10-15 docs: switch to perfboard + KiCad schematic; add implementation plans
    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
2026-10-15 docs(plan): output schematic, wiring and mechanical drawings as PNG
    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
2026-10-15 feat(electrical): generate KiCad schematic and run ERC
    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
    [carrier.kicad_sch]
2026-10-15 feat(electrical): perfboard placement and wiring table
    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
2026-10-15 feat(electrical): perfboard routing (bottom traces, top jumpers) with SVG/PNG views
    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
2026-10-15 feat(core): arcade mixing, slew limiter, brake-decay bridge output
    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
2026-10-15 feat(core): link watchdog, battery monitor, estop latch
    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
2026-10-15 feat(core): stall-based gripper state machine and quadrature decoder
    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
    [gripper.rs, quad.rs]
2026-10-15 feat(core): ultrasonic conversion and 100Hz controller step
    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
2026-10-15 feat(firmware): RTICX firmware wiring robot-core to STM32F103 peripherals
    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
2026-10-15 fix(electrical): deterministic schematic UUIDs
    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
    [carrier.kicad_sch]
2026-10-15 feat(mechanical): parameters and involute gear/rack geometry
    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
2026-10-15 feat(mechanical): pinion, racks and gripper parts
    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
2026-10-15 feat(mechanical): chassis, motor/caster mounts, sonar mount, cutlist
    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
2026-10-15 feat(mechanical): assembly with envelope/interference checks, exports and images
    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
2026-10-15 fix(core): e-stop power-off ramp no longer latches battery Critical
    Absent samples reset the battery monitor; Critical needs 0.5s below 9.9V.
    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
    [safety.rs]
2026-10-15 fix(electrical): Bluepill row A runs opposite to row B (PB12 faces GND at the USB end)
    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
    [carrier.kicad_sch]
2026-10-15 fix(host): stick up drives forward (gilrs Y is already up-positive)
    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
    [mapping.rs]
2026-10-15 fix(core): gripper encoder sign no longer flips the motor output
    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
    [gripper.rs]
2026-10-15 fix(firmware): independent watchdog fed by the control loop
    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
    [main.rs]
2026-10-15 fix(mechanical): model the gripper deck, uprights and rack stops
    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
2026-10-15 feat(mechanical): split clamp for the drive motors, 5mm gripper deck
    Replaces the cantilevered 5x5mm hanger with a clamp around the gearbox body
    bolted to the top and rear faces of the motor cross member. Right-side parts
    are now mirrored across y=0 instead of rotated.
    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
2026-10-15 feat(electrical): two-layer perfboard routing with zero point-to-point wires
    Solder side: bare tinned traces. Component side: insulated wires laid along the
    hole grid, entering holes only at their ends, allowed to cross at right angles.
    Negotiated congestion now converges (0 contested holes), power wires are
    daisy-chained (<= 3 per terminal), board grows to 44 x 36 holes.
    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
2026-10-15 electrical: bus layout with a perimeter GND ring
    Every cable connector now has pin 1 = GND and stands at right angles to
    the board edge with pin 1 on the perimeter, where a bare GND ring on the
    solder side picks them all up. J_BUCK shrinks to 3 pins. Insulated wires
    drop from 45 to 34 and bare traces from 63 to 45 (ring included).
    perfboard.md gains a cable pin-order table for crimping.
    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
    [carrier.kicad_sch]
2026-10-15 Regroup pins and connectors by side: 6 insulated wires instead of 34
    Each Blue Pill row now serves its own side of the board: row B drives the
    left motor (TIM2), left encoder (TIM3), left sonars and the battery
    sense; row A drives the right motor and gripper (TIM4), right encoder
    (TIM1) and right sonars. Every sonar gets its own trigger pin so no
    signal crosses the board, and each connector sits beside its row in pin
    order. Pins tied together on the Blue Pill (3V3, G) count as connected.
    I2C and the spare header are dropped (PB10/PB11 now take echoes).
    Perfboard: 6 insulated wires (from 34), 43 bare traces, 10 power wires.
    Firmware, spec pin table and bring-up doc follow the new assignment.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
    [carrier.kicad_sch]
2026-10-15 electrical: feed the drivers straight from the battery, not via the board
    The DRV8871 modules take battery power on their own terminals, wired from
    the branch after the e-stop. The board loses J_VM_L/G/R; its power input
    now only feeds the buck module and the battery sense, so the AWG18 chain
    shrinks to J_PWR, C_BULK and J_BUCK (4 wires instead of 10).
    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
    [carrier.kicad_sch]
2026-10-15 electrical: insulated wires end in a free hole beside the pin
    A pin's hole is already filled by its lead or socket pin, so an insulated
    wire cannot go into it. Wires now end in a free hole and a bare trace on
    the solder side carries them to the pin. 8 insulated wires; perfboard.md
    spells out the rule.
    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
2026-10-15 electrical: lay the insulated wires on the solder side too
    Insulated wires now go on top of the bare wiring on the solder side
    instead of the component side. Their ends are soldered straight onto a
    pin's joint or onto a bare trace, so no wire has to share a hole with a
    lead, and component bodies no longer get in the way. They may cross bare
    traces and each other, but never run over another pin's joint.
    6 insulated wires, 42 bare traces. A third image shows the insulated
    wires over the greyed-out bare wiring; perfboard.md asks for heat-proof
    (ETFE) wire, since polyurethane enamel melts under the iron.
    Claude-Session: https://claude.ai/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
2026-10-15 electrical: route board power like any other net
    With the drivers fed straight from the harness, the board's VBAT and GND
    only carry the buck module input and the battery sense, so the AWG18
    chain between J_PWR, C_BULK and J_BUCK goes; power is routed on the
    solder side with the signals (43 bare traces, 8 insulated wires).
    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
2026-10-15 spec: board power is wired like the signals
    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
2026-10-15 electrical: shrink the perfboard to 33 x 28 holes (~84 x 71mm)
    The Blue Pill moves up to row 4 and the side regions narrow to what the
    escapes need. Placement was tuned with a small search scored by the
    router, with part outlines (XH housings, terminal block, 8mm can) kept
    apart; a test now checks the outlines do not overlap. Insulated wires
    may cross the GND ring but no longer lie along it.
    8 insulated wires, 41 bare traces. The chassis board mount follows the
    smaller board (90 x 75mm).
    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
2026-10-15 electrical: driver and sonar connectors follow the modules' pin order
    J_DRV becomes XH 4P in the DRV8871 header order (GND, VM, IN1, IN2) with
    VM left unconnected on the board, and J_US follows the HC-SR04 header
    (Vcc, Trig, Echo, Gnd), so the cables run straight through. GND is the
    first or last pin and stays on the board edge; unconnected connector pins
    are now treated as pins by the router and the drawings.
    Placement is provisional (14 insulated wires) until the encoder cable
    order is known; the wire-count test says so and is to be tightened again.
    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
    [carrier.kicad_sch]
2026-10-15 mechanical: battery box, electronics bay and off-board harness plan
    A mid cross member behind the drive wheels and the rear member now carry
    a printed electronics tray (perfboard on standoffs, drivers, buck module,
    main switch, power splice) and a printed open-top battery box held by a
    strap. The board mount no longer floats in mid-air. The electronics are
    kept as one 45mm envelope above the tray.
    harness.py lays out every off-board cable along the extrusions, with cut
    lengths, and writes docs/harness.md and images/harness.png; board
    connector positions come from electrical/netlist.py.
    Claude-Session: https://claude.ai/code/session_01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
2026-10-15 spec: drop the never-written wiring.md, point to where the wiring lives
    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
